tomgrubb/fyp_pcbs/PitchshiftDelay-dsPIC_v2.3.brd

## EAGLE design PitchshiftDelay-dsPIC_v2.3.brd (2018-10-19)

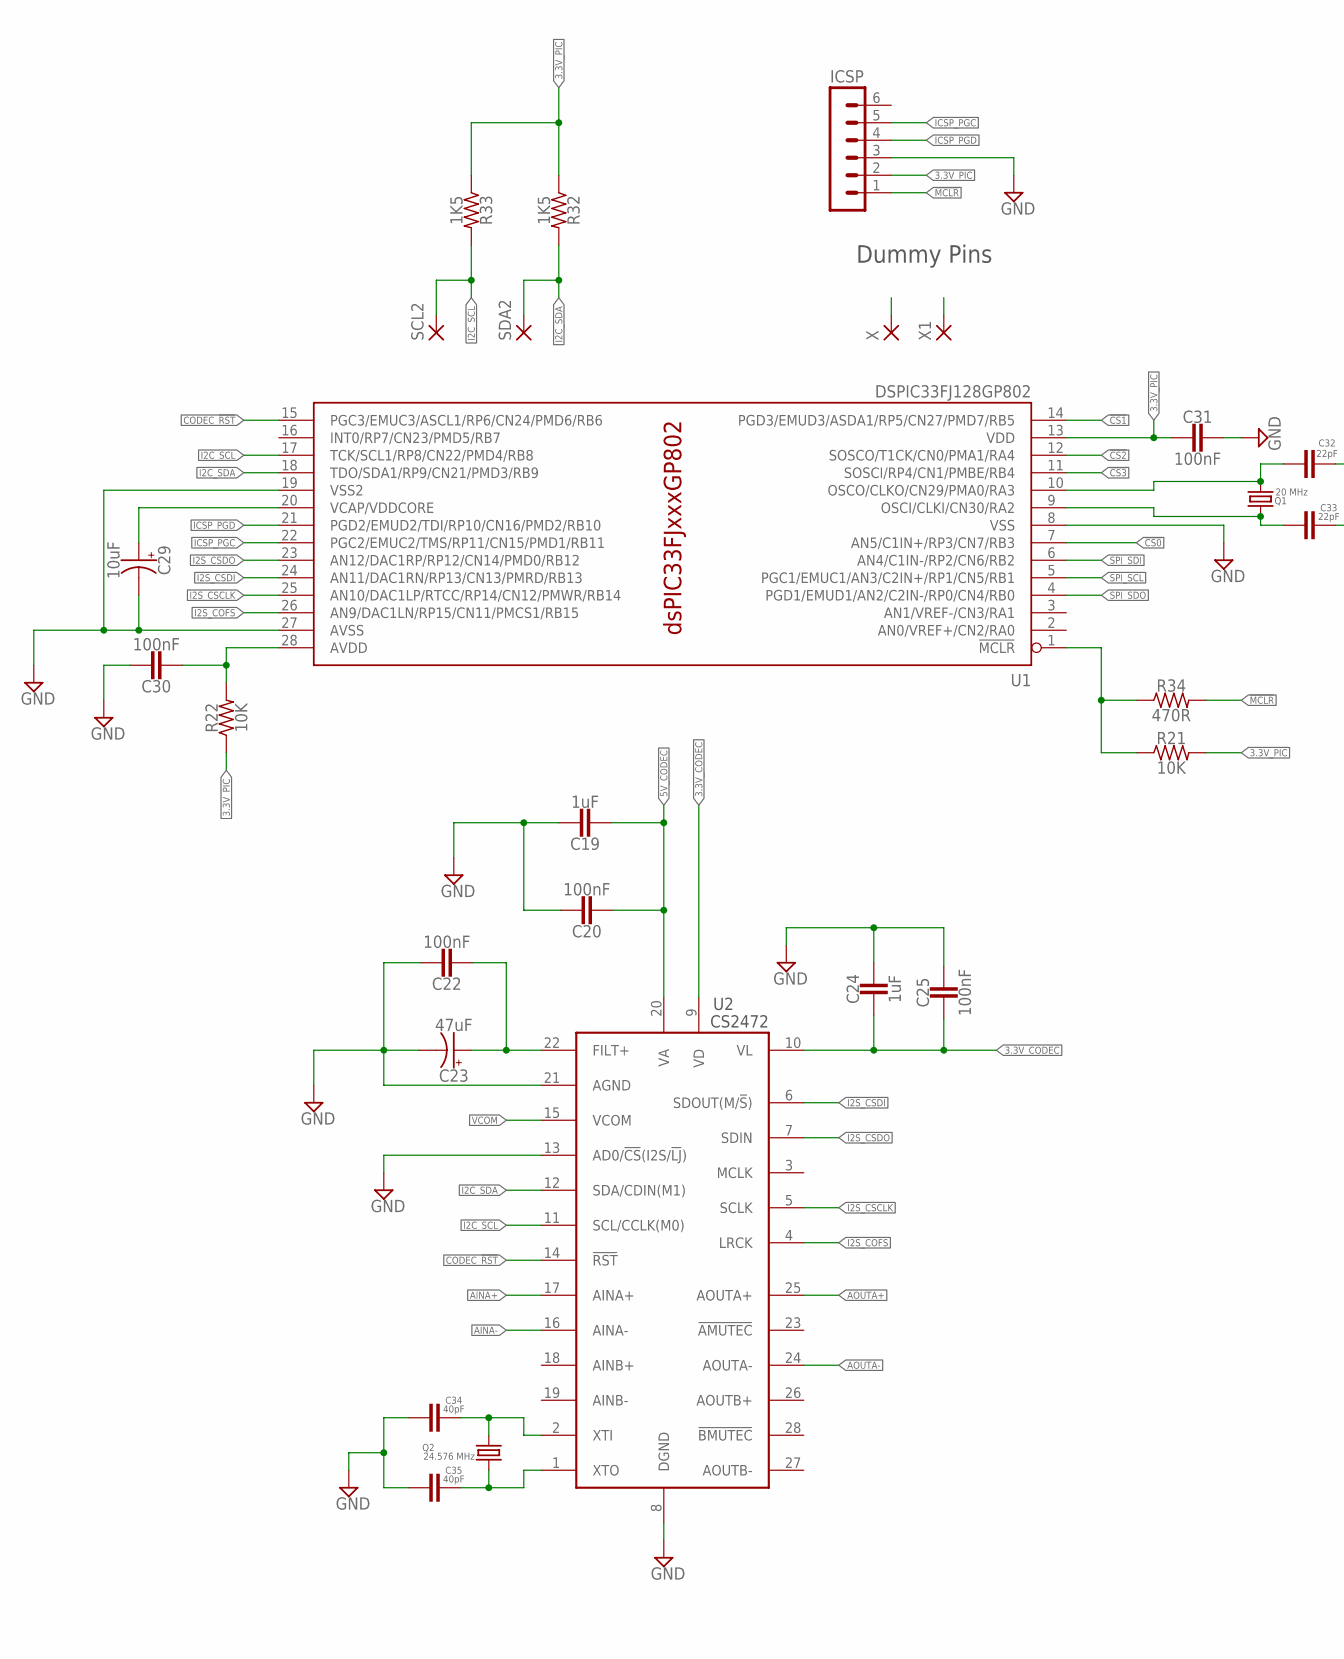
[picture p1: schematic PitchshiftDelay-dsPIC_v2.3.sch, sheet 1, part in row 1, column 1]

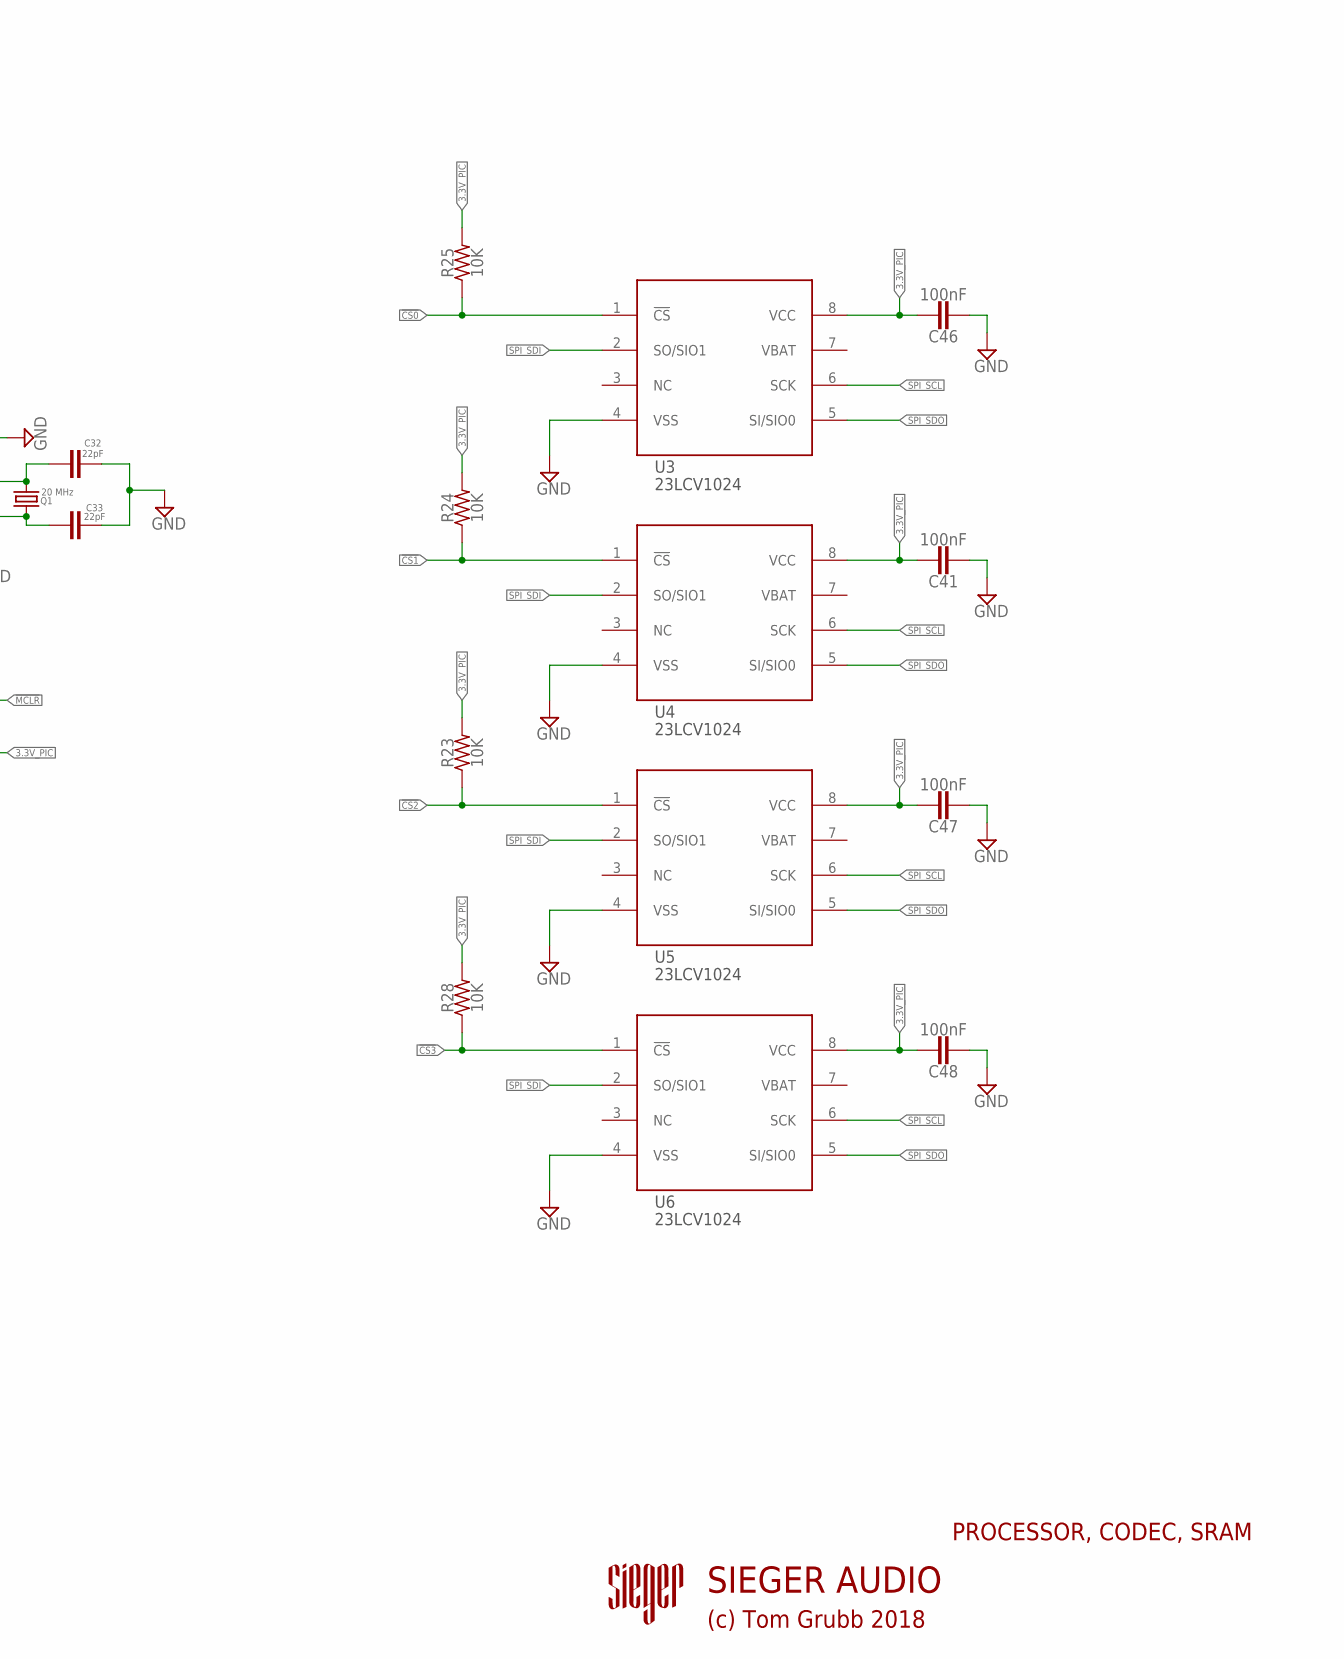
[picture p2: schematic PitchshiftDelay-dsPIC_v2.3.sch, sheet 1, part in row 1, column 2]

Parts:
C19, C24: 1uF; 050X030_025
C20, C22, C25, C30, C31, C41, C46, C47, C48: 100nF; 050X030_025
C23: 47uF; 050_020_1
C29: 10uF; 050_020_1B
C32, C33: 22pF; 0805
C34, C35: 40pF; 0805
ICSP: MA06-1
Q1: 20 MHz; HC49U-V
Q2: 24.576 MHz; HC49U-V
R21, R22, R23, R24, R25, R28: 10K; RESISTOR_C0805
R32, R33: 1K5; RESISTOR_C0805
R34: 470R; RESISTOR_C0805
SCL2: 2,15/1,0
SDA2: 2,15/1,0
U1: DSPIC33FJ128GP802; SO28W
U2: CS2472; TSSOP28L
U3, U4, U5, U6: 23LCV1024; SOIC8
X, X1: 2,15/1,0

Connections:
3.3V_CODEC: C24.2, C25.2, U2.9 (VD), U2.10 (VL); also elsewhere on the board
3.3V_PIC: C31.2, C41.1, C46.1, C47.1, C48.1, ICSP.2, R21.2, R22.1, R23.2, R24.2, R25.2, R28.2, R32.1, R33.1, U1.13 (VDD), U3.8 (VCC), U4.8 (VCC), U5.8 (VCC), U6.8 (VCC); also elsewhere on the board
5V_CODEC: C19.2, C20.2, U2.20 (VA); also elsewhere on the board
!CS0: R25.1, U1.7 (AN5/C1IN+/RP3/CN7/RB3), U3.1 (!CS)
!CS1: R24.1, U1.14 (PGD3/EMUD3/ASDA1/RP5/CN27/PMD7/RB5), U4.1 (!CS)
!CS2: R23.1, U1.12 (SOSCO/T1CK/CN0/PMA1/RA4), U5.1 (!CS)
!CS3: R28.1, U1.11 (SOSCI/RP4/CN1/PMBE/RB4), U6.1 (!CS)
!MCLR: ICSP.1, R34.2
AINA+: U2.17 (AINA+); also elsewhere on the board
AINA-: U2.16 (AINA-); also elsewhere on the board
AOUTA+: U2.25 (AOUTA+); also elsewhere on the board
AOUTA-: U2.24 (AOUTA-); also elsewhere on the board
CODEC_!RST: U1.15 (PGC3/EMUC3/ASCL1/RP6/CN24/PMD6/RB6), U2.14 (!RST)
FILT+: C22.2, C23.+, U2.22 (FILT+)
GND: C19.1, C20.1, C22.1, C23.-, C24.1, C25.1, C29.-, C30.1, C31.1, C32.1, C33.1, C34.2, C35.2, C41.2, C46.2, C47.2, C48.2, ICSP.3, U1.8 (VSS), U1.19 (VSS2), U1.27 (AVSS), U2.8 (DGND), U2.13 (AD0/!CS!(I2S/!LJ!)), U2.21 (AGND), U3.4 (VSS), U4.4 (VSS), U5.4 (VSS), U6.4 (VSS); also elsewhere on the board
I2C_SCL: R33.2, SCL2.1, U1.17 (TCK/SCL1/RP8/CN22/PMD4/RB8), U2.11 (SCL/CCLK(M0)), X.1
I2C_SDA: R32.2, SDA2.1, U1.18 (TDO/SDA1/RP9/CN21/PMD3/RB9), U2.12 (SDA/CDIN(M1))
I2S_COFS: U1.26 (AN9/DAC1LN/RP15/CN11/PMCS1/RB15), U2.4 (LRCK)
I2S_CSCLK: U1.25 (AN10/DAC1LP/RTCC/RP14/CN12/PMWR/RB14), U2.5 (SCLK)
I2S_CSDI: U1.24 (AN11/DAC1RN/RP13/CN13/PMRD/RB13), U2.6 (SDOUT(M/!S!))
I2S_CSDO: U1.23 (AN12/DAC1RP/RP12/CN14/PMD0/RB12), U2.7 (SDIN)
ICSP_PGC: ICSP.5, U1.22 (PGC2/EMUC2/TMS/RP11/CN15/PMD1/RB11)
ICSP_PGD: ICSP.4, U1.21 (PGD2/EMUD2/TDI/RP10/CN16/PMD2/RB10)
unnamed: C30.2, R22.2, U1.28 (AVDD)
unnamed: C29.+, U1.20 (VCAP/VDDCORE)
unnamed: C33.2, Q1.1, U1.9 (OSCI/CLKI/CN30/RA2)
unnamed: C32.2, Q1.2, U1.10 (OSCO/CLKO/CN29/PMA0/RA3)
unnamed: R21.1, R34.1, U1.1 (!MCLR)
unnamed: C34.1, Q2.2, U2.2 (XTI)
unnamed: C35.1, Q2.1, U2.1 (XTO)
SPI_SCL: U1.5 (PGC1/EMUC1/AN3/C2IN+/RP1/CN5/RB1), U3.6 (SCK), U4.6 (SCK), U5.6 (SCK), U6.6 (SCK)
SPI_SDI: U1.6 (AN4/C1IN-/RP2/CN6/RB2), U3.2 (SO/SIO1), U4.2 (SO/SIO1), U5.2 (SO/SIO1), U6.2 (SO/SIO1)
SPI_SDO: U1.4 (PGD1/EMUD1/AN2/C2IN-/RP0/CN4/RB0), U3.5 (SI/SIO0), U4.5 (SI/SIO0), U5.5 (SI/SIO0), U6.5 (SI/SIO0)
VCOM: U2.15 (VCOM); also elsewhere on the board

Notes on the sheet:
PROCESSOR, CODEC, SRAM
Dummy Pins
(c) Tom Grubb 2018
SIEGER AUDIO

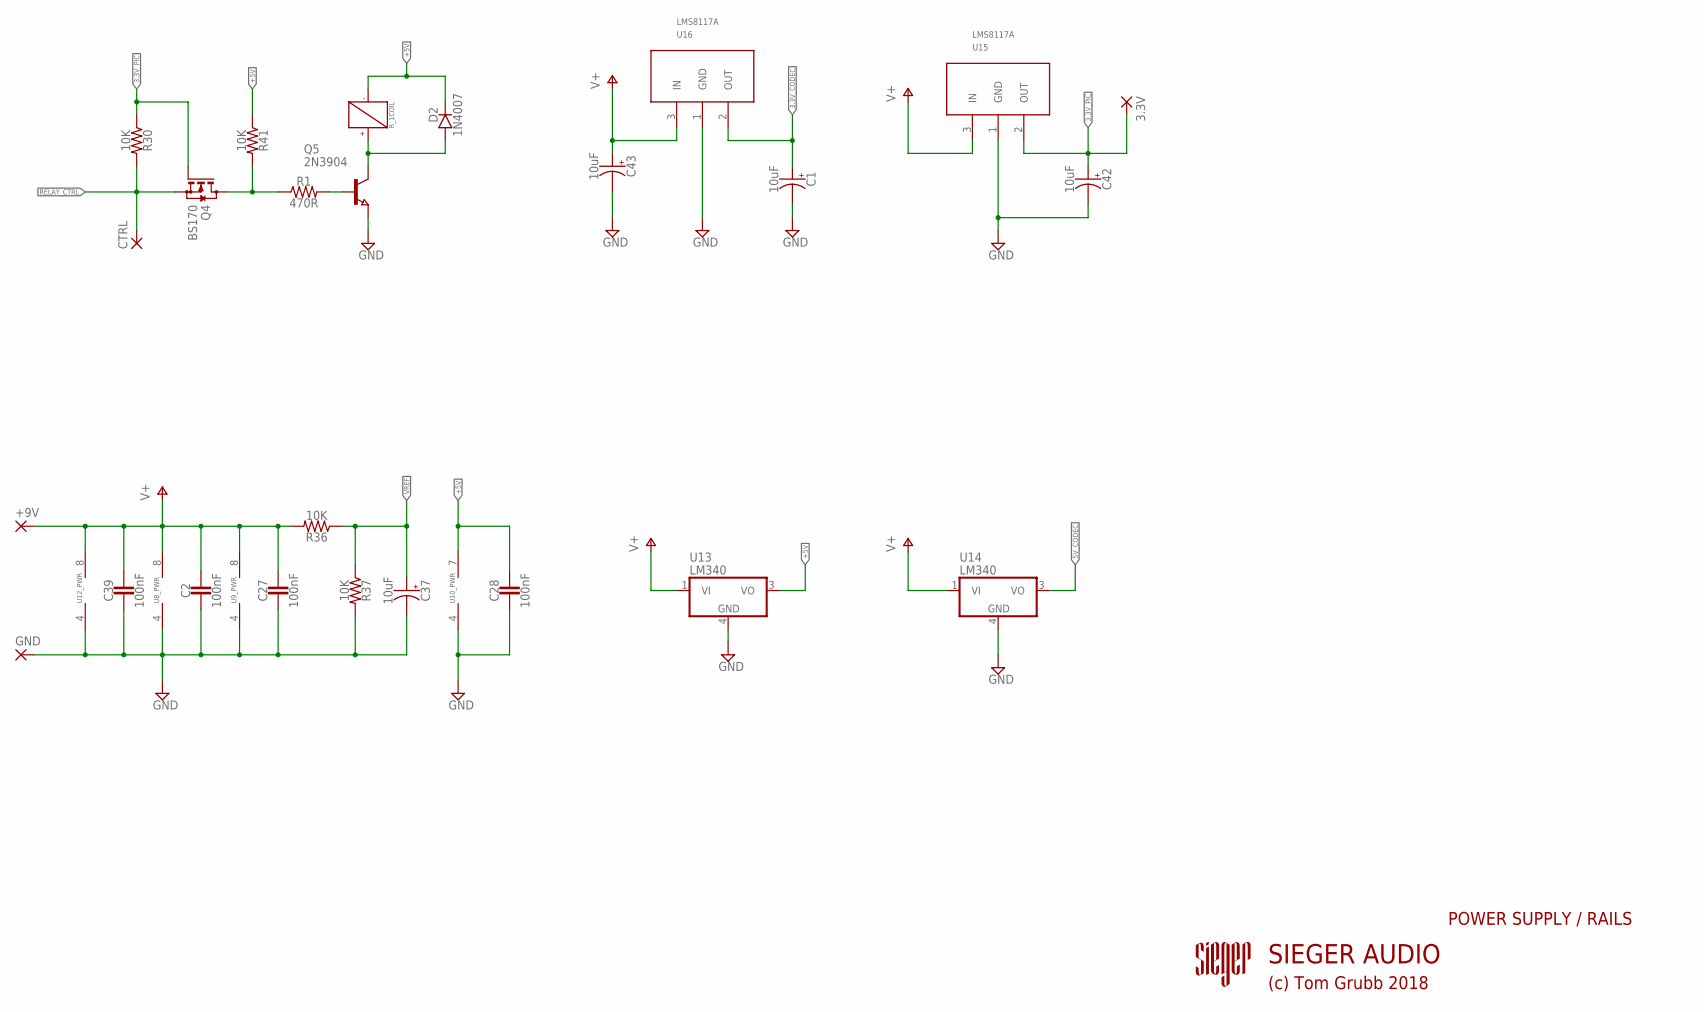
[picture p3: schematic PitchshiftDelay-dsPIC_v2.3.sch, sheet 2]

Parts:
3.3V: 2,15/1,0
+9V: 2,15/1,0
C1, C37, C42, C43: 10uF; 050_020_1
C2, C27, C28, C39: 100nF; 050X030_025
CTRL: 2,15/1,0
D2: 1N4007; DO35-3
GND: 2,15/1,0
Q4: BS170; SOT23
Q5: 2N3904; SOT23
R1: 470R; RESISTOR_C0805
R30, R36, R37, R41: 10K; RESISTOR_C0805
R_1: AL5WNK_2; 10PIN
U8, U9, U12: LF353; SO08
U10: OP1177; MSOP8
U13, U14: LM340; SOT223
U15, U16: LMS8117A; SOT223

Connections:
3.3V_CODEC: C1.+, U16.2 (OUT); also elsewhere on the board
3.3V_PIC: 3.3V.1, C42.+, Q4.1 (G), R30.1, U15.2 (OUT); also elsewhere on the board
5V_CODEC: U14.3 (VO); also elsewhere on the board
+5V: C28.1, D2.C, R41.1, R_1.P$10 (-), U10.7 (V+), U13.3 (VO); also elsewhere on the board
GND: C1.-, C2.2, C27.2, C28.2, C37.-, C39.2, C42.-, C43.-, GND.1, Q5.2 (E), R37.2, U8.4 (V-), U9.4 (V-), U10.4 (V-), U12.4 (V-), U13.4 (GND), U14.4 (GND), U15.1 (GND), U16.1 (GND); also elsewhere on the board
unnamed: Q5.1 (B), R1.2
unnamed: D2.A, Q5.3 (C), R_1.P$1 (+)
unnamed: Q4.3 (D), R1.1, R41.2
RELAY_CTRL: CTRL.1, Q4.2 (S), R30.2
V+: +9V.1, C2.1, C27.1, C39.1, C43.+, R36.2, U8.8 (V+), U9.8 (V+), U12.8 (V+), U13.1 (VI), U14.1 (VI), U15.3 (IN), U16.3 (IN)
VREF: C37.+, R36.1, R37.1; also elsewhere on the board

Notes on the sheet:
POWER SUPPLY / RAILS
(c) Tom Grubb 2018
SIEGER AUDIO

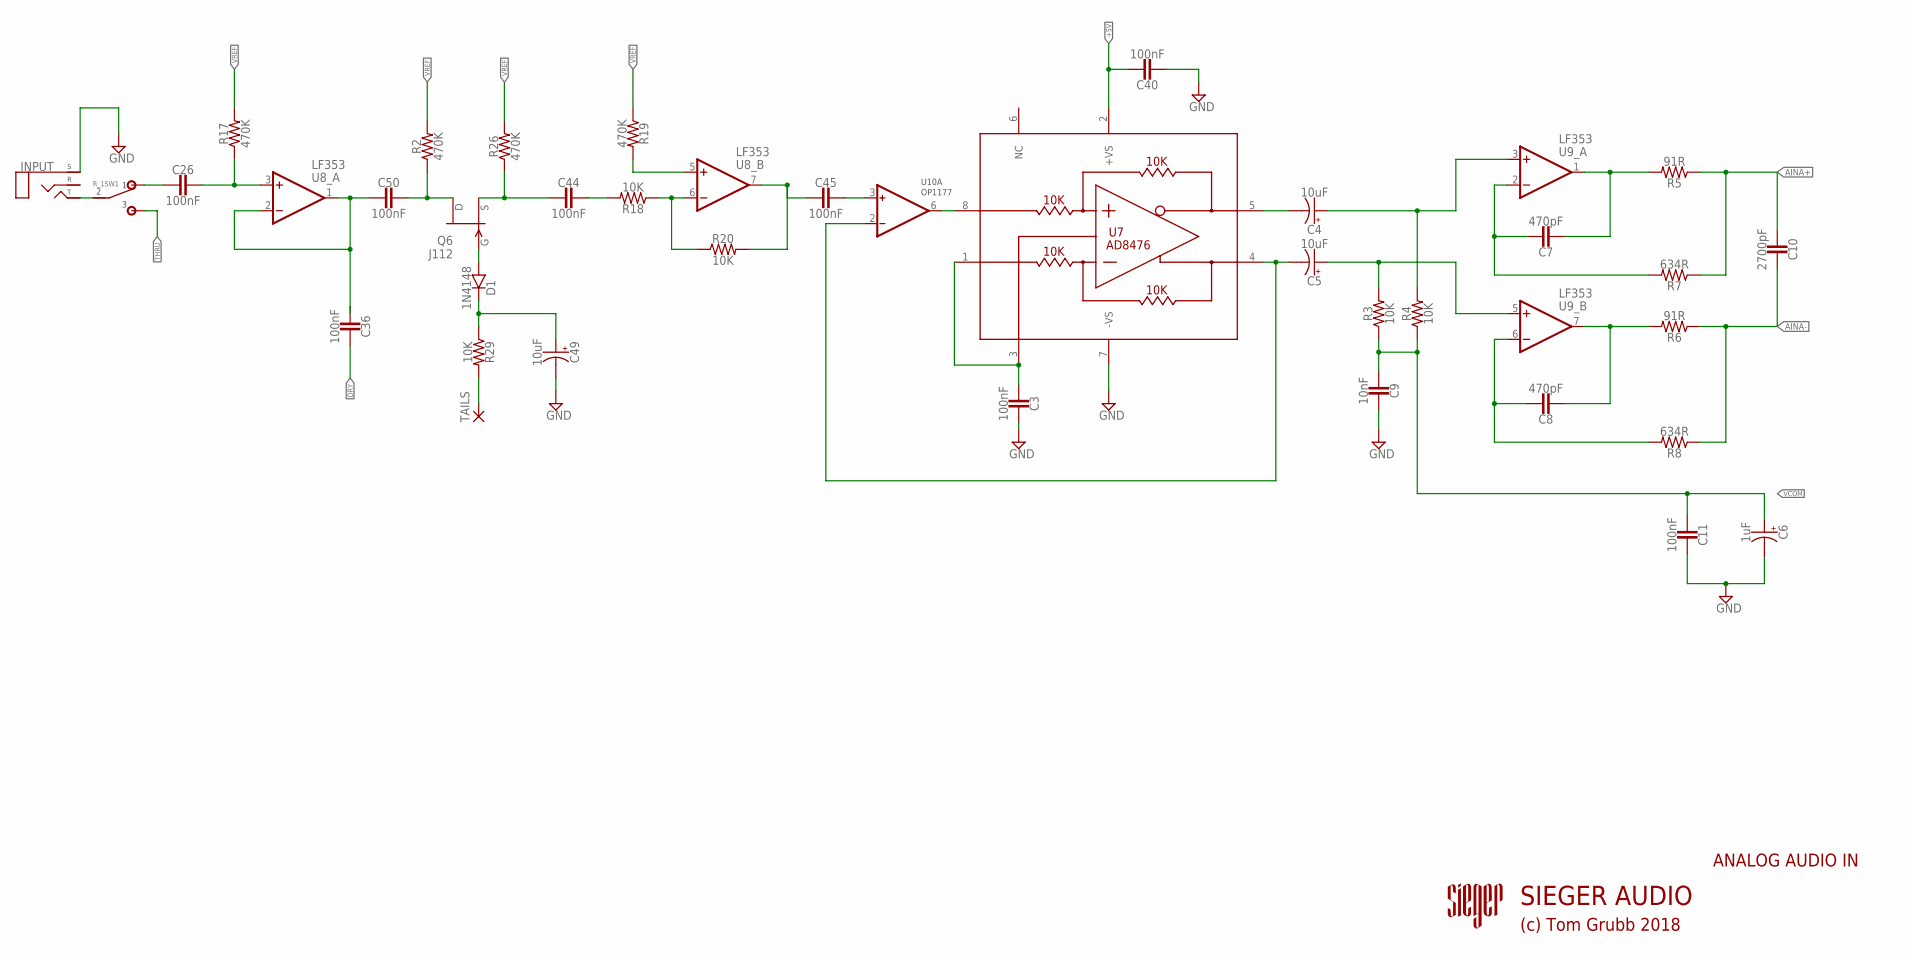
[picture p4: schematic PitchshiftDelay-dsPIC_v2.3.sch, sheet 3]

Parts:
C3, C11, C40: 100nF; 050X030_025
C4, C5, C49: 10uF; 050_020_1
C6: 1uF; 050_020_1
C7, C8: 470pF; BOX_SMALL
C9: 10nF; 050X030_025
C10: 2700pF; BOX_SMALL
C26, C36, C44, C45, C50: 100nF; BOX_SMALL
D1: 1N4148; DO35-3
INPUT: STEREO; STEREO_PCB
Q6: J112; SOT23
R2, R17, R19, R26: 470K; RESISTOR_C0805
R3, R4, R18, R20, R29: 10K; RESISTOR_C0805
R5, R6: 91R; RESISTOR_C0805
R7, R8: 634R; RESISTOR_C0805
R_1: AL5WNK_2; 10PIN
TAILS: 2,15/1,0
U7: AD8476; MSOP8
U8, U9: LF353; SO08
U10: OP1177; MSOP8

Connections:
+5V: C40.1, U7.2 (+VS); also elsewhere on the board
AINA+: C10.2, R5.1, R7.1; also elsewhere on the board
AINA-: C10.1, R6.1, R8.1; also elsewhere on the board
DRY: C36.1; also elsewhere on the board
GND: C3.1, C6.-, C9.1, C11.1, C40.2, C49.-, INPUT.P$1 (S), U7.7 (-VS); also elsewhere on the board
unnamed: C45.1, U10.3 (+IN)
unnamed: C3.2, U7.1 (IN-), U7.3 (VCOM)
unnamed: U7.8 (IN+), U10.6 (OUT)
unnamed: C5.-, U7.4 (+OUT), U10.2 (-IN)
unnamed: C36.2, C50.2, U8.1 (OUT), U8.2 (-IN)
unnamed: C26.1, R17.1, U8.3 (+IN)
unnamed: C4.-, U7.5 (-OUT)
unnamed: C5.+, R3.2, U9.5 (+IN)
unnamed: C4.+, R4.2, U9.3 (+IN)
unnamed: C8.1, R8.2, U9.6 (-IN)
unnamed: C8.2, R6.2, U9.7 (OUT)
unnamed: C7.1, R7.2, U9.2 (-IN)
unnamed: C7.2, R5.2, U9.1 (OUT)
unnamed: C26.2, R_1.P$2 (1)
unnamed: R18.1, R20.1, U8.6 (-IN)
unnamed: R19.2, U8.5 (+IN)
unnamed: C50.1, Q6.1 (D), R2.1
unnamed: C45.2, R20.2, U8.7 (OUT)
unnamed: C44.1, R18.2
unnamed: INPUT.P$3 (T), R_1.P$3 (2)
unnamed: C44.2, Q6.2 (S), R26.1
unnamed: C49.+, D1.C, R29.1
unnamed: D1.A, Q6.3 (G)
unnamed: R29.2, TAILS.1
THRU: R_1.P$4 (3); also elsewhere on the board
VCOM: C6.+, C9.2, C11.2, R3.1, R4.1; also elsewhere on the board
VREF: R2.2, R17.2, R19.1, R26.2; also elsewhere on the board

Notes on the sheet:
ANALOG AUDIO IN
(c) Tom Grubb 2018
SIEGER AUDIO

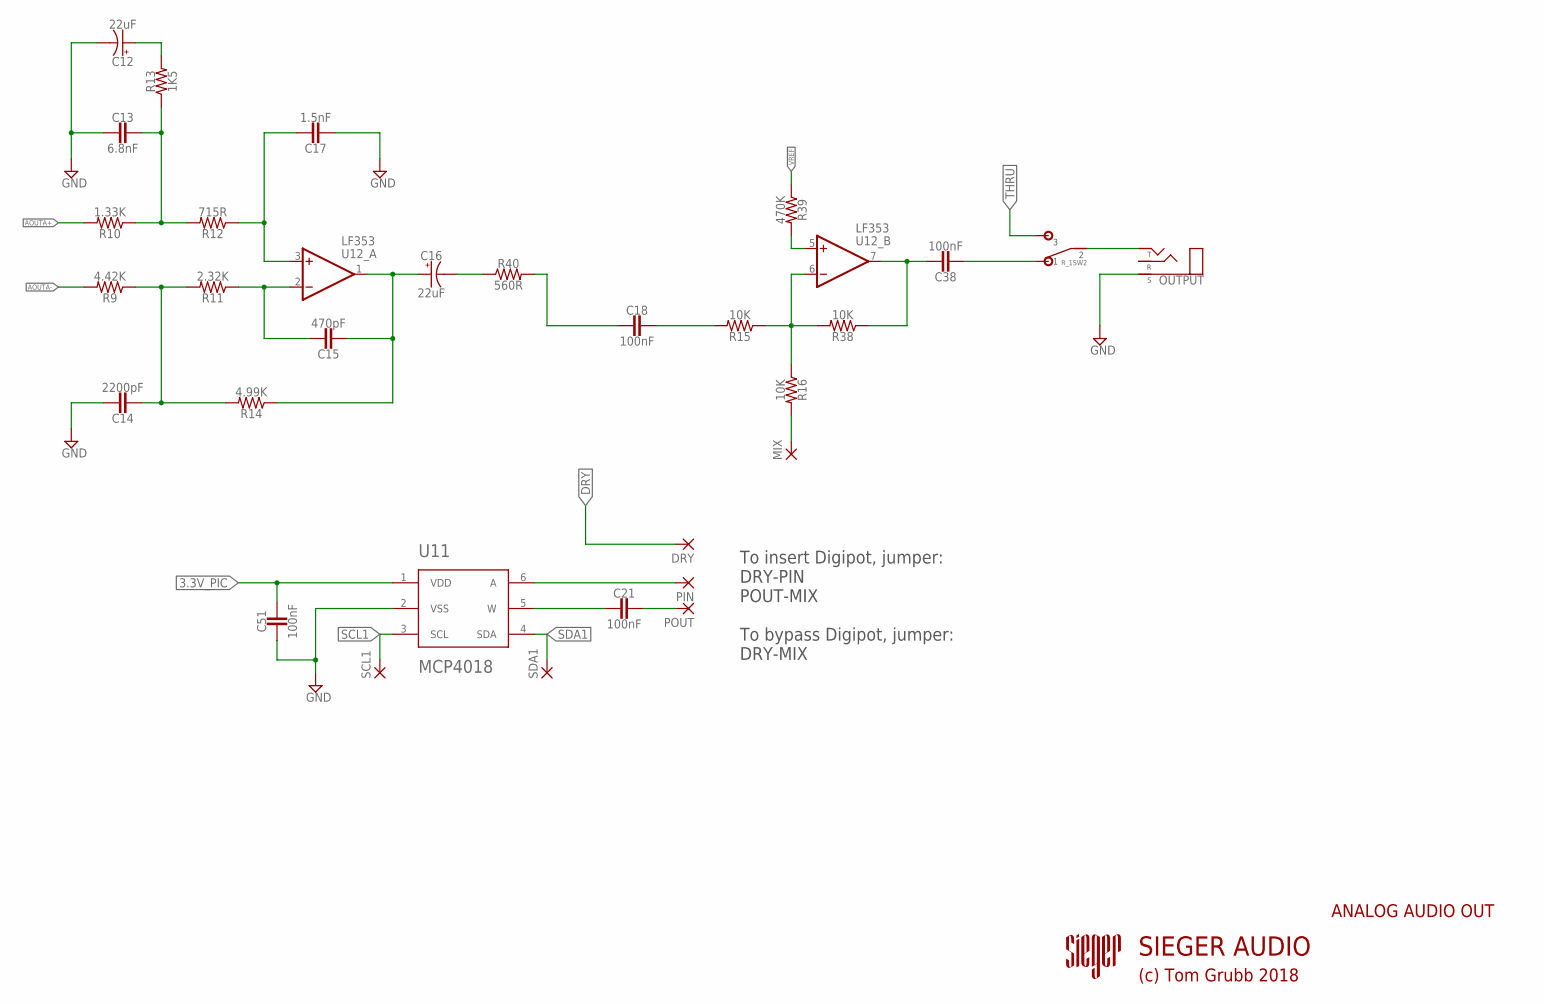
[picture p5: schematic PitchshiftDelay-dsPIC_v2.3.sch, sheet 4]

Parts:
C12, C16: 22uF; 050_020_1
C13: 6.8nF; BOX_SMALL
C14: 2200pF; BOX_SMALL
C15: 470pF; BOX_SMALL
C17: 1.5nF; BOX_SMALL
C18, C21, C38: 100nF; BOX_SMALL
C51: 100nF; 050X030_025
DRY: 2,15/1,0
MIX: 2,15/1,0
OUTPUT: STEREO; STEREO_PCB
PIN: 2,15/1,0
POUT: 2,15/1,0
R9: 4.42K; RESISTOR_C0805
R10: 1.33K; RESISTOR_C0805
R11: 2.32K; RESISTOR_C0805
R12: 715R; RESISTOR_C0805
R13: 1K5; RESISTOR_C0805
R14: 4.99K; RESISTOR_C0805
R15, R16, R38: 10K; RESISTOR_C0805
R39: 470K; RESISTOR_C0805
R40: 560R; RESISTOR_C0805
R_1: AL5WNK_2; 10PIN
SCL1: 2,15/1,0
SDA1: 2,15/1,0
U11: MCP4018; SC70-6
U12: LF353; SO08

Connections:
3.3V_PIC: C51.1, U11.1 (VDD); also elsewhere on the board
AMUTE: C18.2, R40.2
AOUTA+: R10.2; also elsewhere on the board
AOUTA-: R9.2; also elsewhere on the board
DRY: DRY.1; also elsewhere on the board
GND: C12.-, C13.2, C14.1, C17.2, C51.2, OUTPUT.P$1 (S), U11.2 (VSS); also elsewhere on the board
unnamed: C21.2, U11.5 (W)
unnamed: C16.-, R40.1
unnamed: C13.1, R10.1, R12.2, R13.1
unnamed: C14.2, R9.1, R11.2, R14.2
unnamed: C15.1, R11.1, U12.2 (-IN)
unnamed: C17.1, R12.1, U12.3 (+IN)
unnamed: C15.2, C16.+, R14.1, U12.1 (OUT)
unnamed: MIX.1, R16.2
unnamed: C18.1, R15.2
unnamed: C12.+, R13.2
unnamed: OUTPUT.P$3 (T), R_1.P$8 (2)
unnamed: C38.2, R_1.P$9 (1)
unnamed: PIN.1, U11.6 (A)
unnamed: R15.1, R16.1, R38.2, U12.6 (-IN)
unnamed: C38.1, R38.1, U12.7 (OUT)
unnamed: R39.2, U12.5 (+IN)
unnamed: C21.1, POUT.1
SCL1: SCL1.1, U11.3 (SCL)
SDA1: SDA1.1, U11.4 (SDA)
THRU: R_1.P$7 (3); also elsewhere on the board
VREF: R39.1; also elsewhere on the board

Notes on the sheet:
To insert Digipot, jumper: DRY-PIN POUT-MIX To bypass Digipot, jumper: DRY-MIX
ANALOG AUDIO OUT
(c) Tom Grubb 2018
SIEGER AUDIO

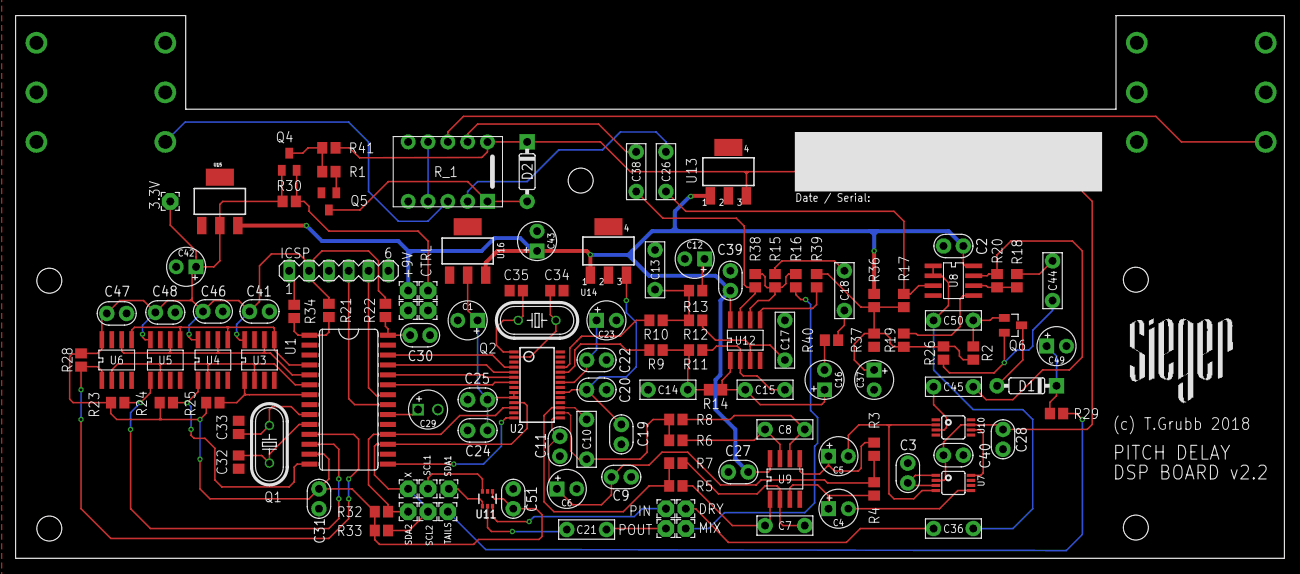
[picture p6: board PitchshiftDelay-dsPIC_v2.3.brd from above]

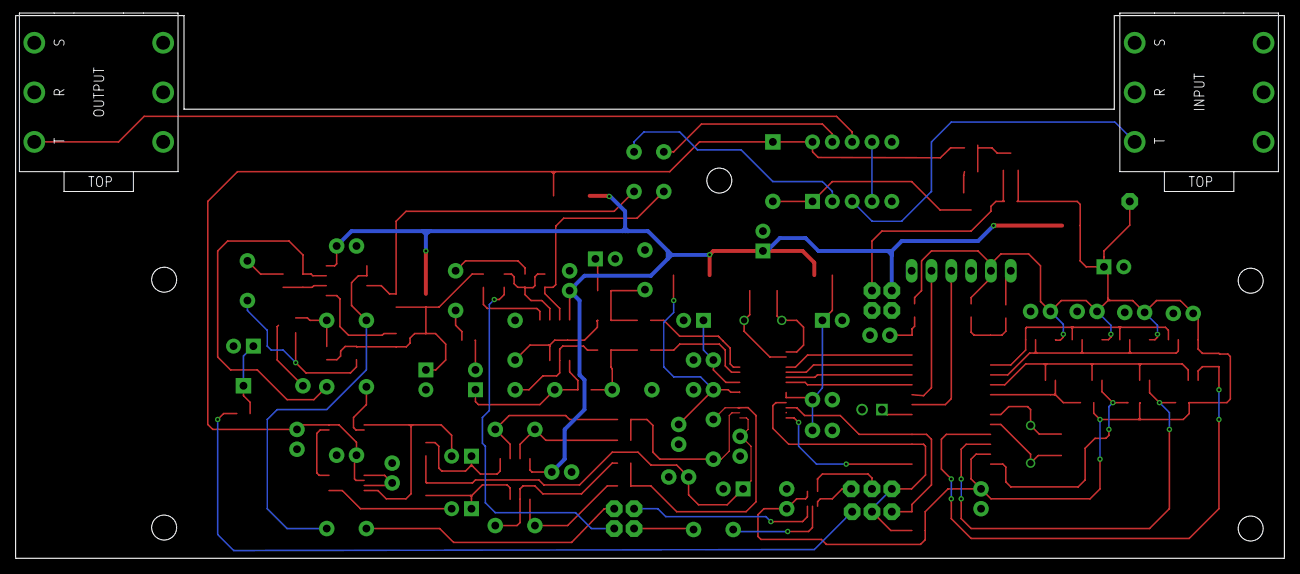
[picture p7: board PitchshiftDelay-dsPIC_v2.3.brd from below]

Board: 2 copper layers, 162.5 x 69.5 mm, 132 parts (2 on the bottom side), 87 nets.

Other parts of the board:
U$1: LARGE
