tomgrubb/fyp_pcbs/PitchshiftDelay-Control-v1.2.brd

## EAGLE design PitchshiftDelay-Control-v1.2.brd (2018-10-19)

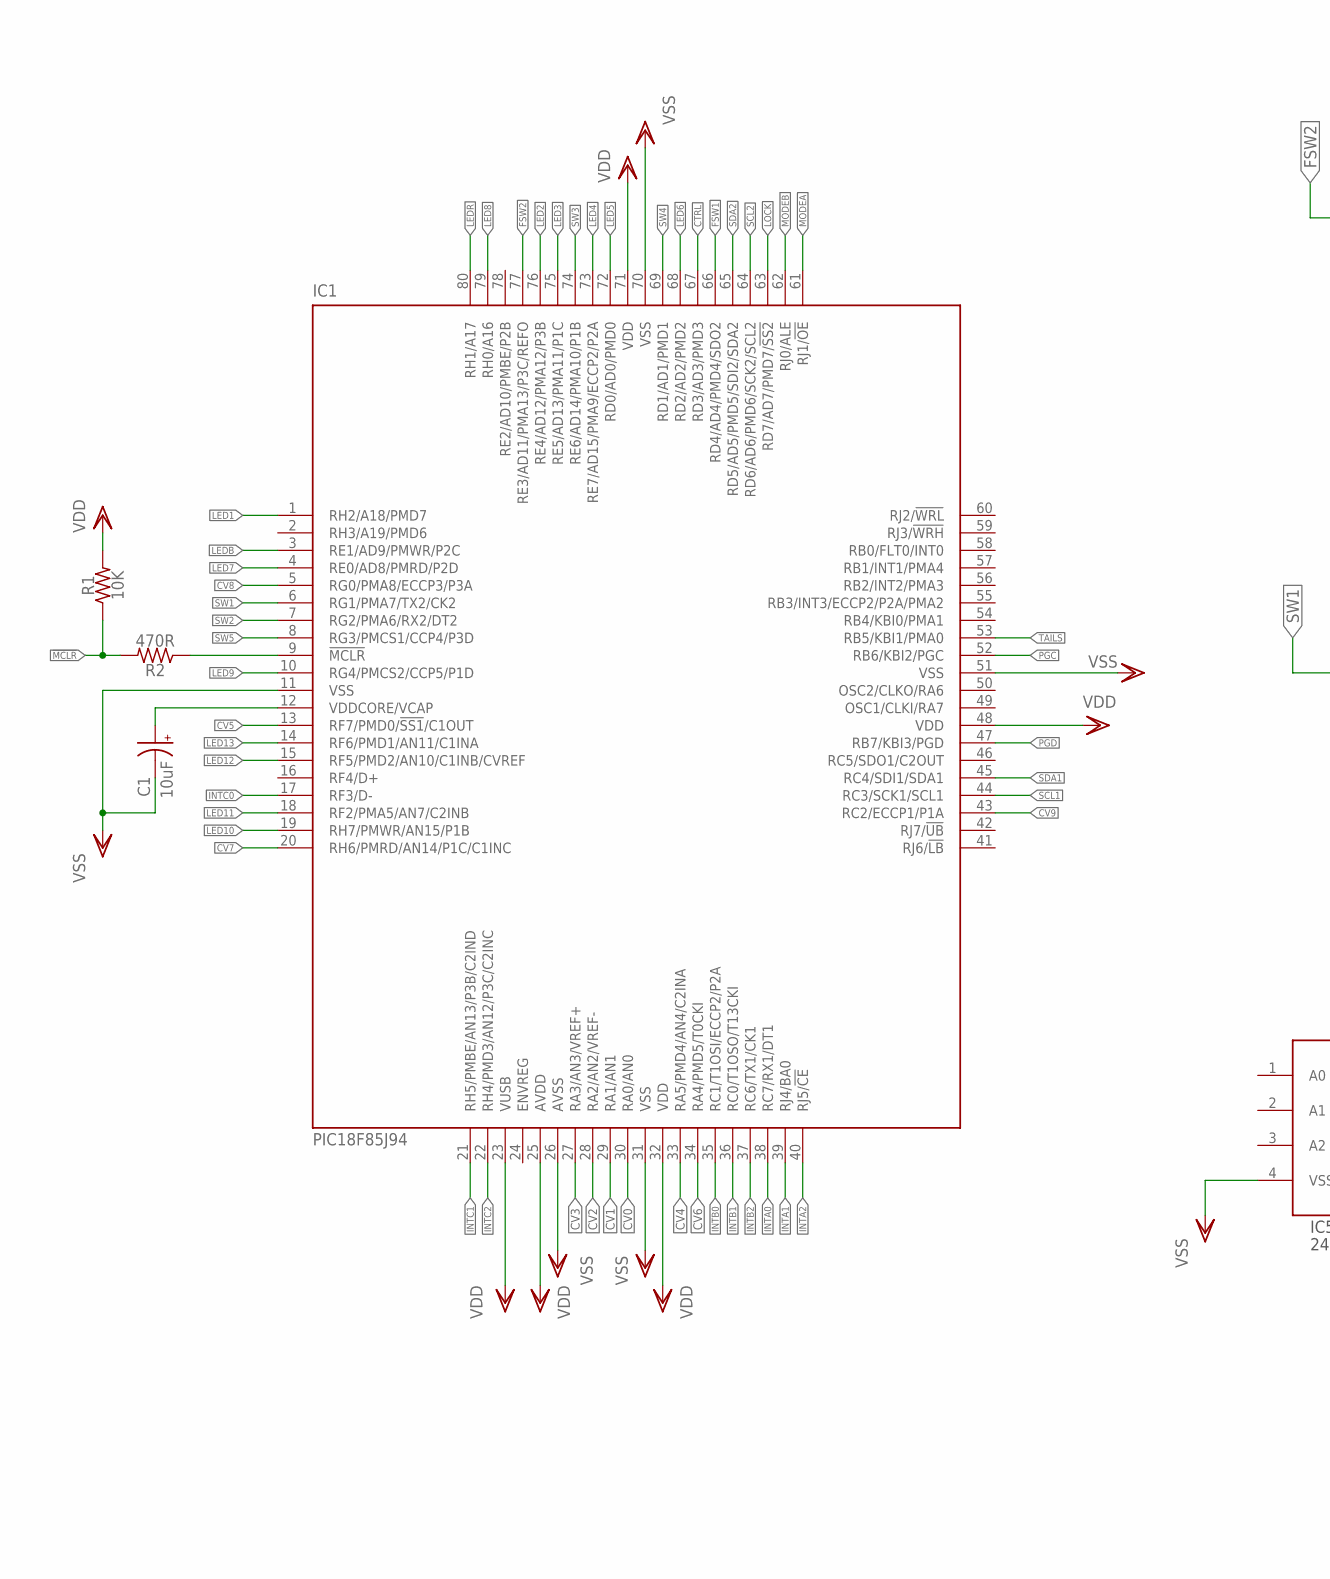
[picture p8: schematic PitchshiftDelay-Control-v1.2.sch, sheet 1, part in row 1, column 1]

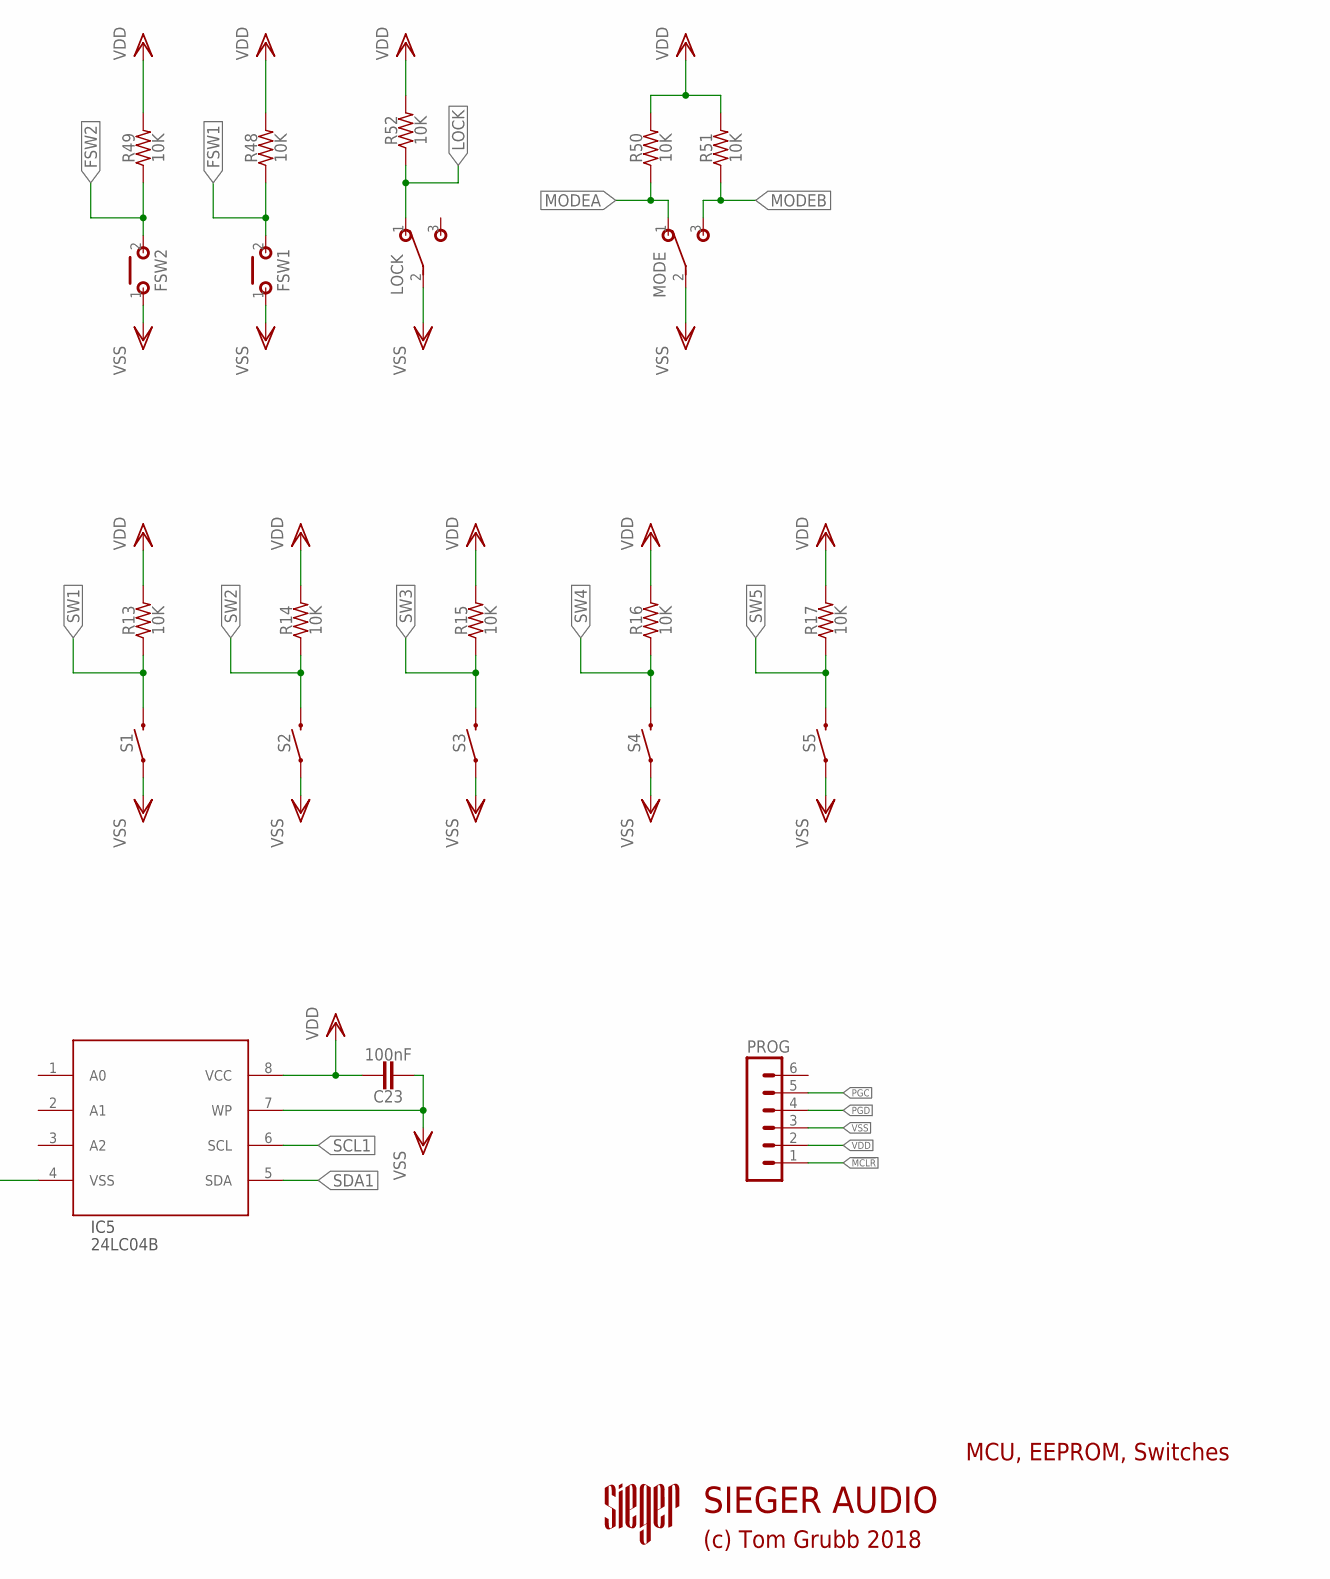
[picture p9: schematic PitchshiftDelay-Control-v1.2.sch, sheet 1, part in row 1, column 2]

Parts:
C1: 10uF; 050_020_1
C23: 100nF; 050X030_025
FSW1, FSW2: MOMENTARY; SPST
IC1: PIC18F85J94; TQFP80-12X12
IC5: 24LC04B; SOIC8
LOCK: SPDTPIN_MOUNT; 1MS1T1B1C0M2QE
MODE: SPDTPIN_MOUNT; 1MS1T1B1C0M2QE
PROG: MA06-1
R1, R13, R14, R15, R16, R17, R48, R49, R50, R51, R52: 10K; RESISTOR_C0805
R2: 470R; RESISTOR_C0805
S1, S2, S3, S4, S5: MOMENTARY-SWITCH-SPST-PTH-6.0MM; TACTILE_SWITCH_PTH_6.0MM

Connections:
!MCLR: PROG.1, R1.1, R2.2
CTRL: IC1.67 (RD3/AD3/PMD3); also elsewhere on the board
CV0: IC1.30 (RA0/AN0); also elsewhere on the board
CV1: IC1.29 (RA1/AN1); also elsewhere on the board
CV2: IC1.28 (RA2/AN2/VREF-); also elsewhere on the board
CV3: IC1.27 (RA3/AN3/VREF+); also elsewhere on the board
CV4: IC1.33 (RA5/PMD4/AN4/C2INA); also elsewhere on the board
CV5: IC1.13 (RF7/PMD0/!SS1!/C1OUT); also elsewhere on the board
CV6: IC1.34 (RA4/PMD5/T0CKI); also elsewhere on the board
CV7: IC1.20 (RH6/PMRD/AN14/P1C/C1INC); also elsewhere on the board
CV8: IC1.5 (RG0/PMA8/ECCP3/P3A); also elsewhere on the board
CV9: IC1.43 (RC2/ECCP1/P1A); also elsewhere on the board
FSW1: FSW1.2 (S), IC1.66 (RD4/AD4/PMD4/SDO2), R48.1
FSW2: FSW2.2 (S), IC1.77 (RE3/AD11/PMA13/P3C/REFO), R49.1
INTA0: IC1.38 (RC7/RX1/DT1); also elsewhere on the board
INTA1: IC1.39 (RJ4/BA0); also elsewhere on the board
INTA2: IC1.40 (RJ5/!CE); also elsewhere on the board
INTB0: IC1.35 (RC1/T1OSI/ECCP2/P2A); also elsewhere on the board
INTB1: IC1.36 (RC0/T1OSO/T13CKI); also elsewhere on the board
INTB2: IC1.37 (RC6/TX1/CK1); also elsewhere on the board
INTC0: IC1.17 (RF3/D-); also elsewhere on the board
INTC1: IC1.21 (RH5/PMBE/AN13/P3B/C2IND); also elsewhere on the board
INTC2: IC1.22 (RH4/PMD3/AN12/P3C/C2INC); also elsewhere on the board
LED1: IC1.1 (RH2/A18/PMD7); also elsewhere on the board
LED2: IC1.76 (RE4/AD12/PMA12/P3B); also elsewhere on the board
LED3: IC1.75 (RE5/AD13/PMA11/P1C); also elsewhere on the board
LED4: IC1.73 (RE7/AD15/PMA9/ECCP2/P2A); also elsewhere on the board
LED5: IC1.72 (RD0/AD0/PMD0); also elsewhere on the board
LED6: IC1.68 (RD2/AD2/PMD2); also elsewhere on the board
LED7: IC1.4 (RE0/AD8/PMRD/P2D); also elsewhere on the board
LED8: IC1.79 (RH0/A16); also elsewhere on the board
LED9: IC1.10 (RG4/PMCS2/CCP5/P1D); also elsewhere on the board
LED10: IC1.19 (RH7/PMWR/AN15/P1B); also elsewhere on the board
LED11: IC1.18 (RF2/PMA5/AN7/C2INB); also elsewhere on the board
LED12: IC1.15 (RF5/PMD2/AN10/C1INB/CVREF); also elsewhere on the board
LED13: IC1.14 (RF6/PMD1/AN11/C1INA); also elsewhere on the board
LEDB: IC1.3 (RE1/AD9/PMWR/P2C); also elsewhere on the board
LEDR: IC1.80 (RH1/A17); also elsewhere on the board
LOCK: IC1.63 (RD7/AD7/PMD7/!SS2), LOCK.1 (O), R52.1
MODEA: IC1.61 (RJ1/!OE), MODE.1 (O), R50.1
MODEB: IC1.62 (RJ0/ALE), MODE.3 (S), R51.1
unnamed: C1.+, IC1.12 (VDDCORE/VCAP)
unnamed: IC1.9 (!MCLR), R2.1
PGC: IC1.52 (RB6/KBI2/PGC), PROG.5
PGD: IC1.47 (RB7/KBI3/PGD), PROG.4
SCL1: IC1.44 (RC3/SCK1/SCL1), IC5.6 (SCL); also elsewhere on the board
SCL2: IC1.64 (RD6/AD6/PMD6/SCK2/SCL2); also elsewhere on the board
SDA1: IC1.45 (RC4/SDI1/SDA1), IC5.5 (SDA); also elsewhere on the board
SDA2: IC1.65 (RD5/AD5/PMD5/SDI2/SDA2); also elsewhere on the board
SW1: IC1.6 (RG1/PMA7/TX2/CK2), R13.1, S1.3 (2)
SW2: IC1.7 (RG2/PMA6/RX2/DT2), R14.1, S2.3 (2)
SW3: IC1.74 (RE6/AD14/PMA10/P1B), R15.1, S3.3 (2)
SW4: IC1.69 (RD1/AD1/PMD1), R16.1, S4.3 (2)
SW5: IC1.8 (RG3/PMCS1/CCP4/P3D), R17.1, S5.3 (2)
TAILS: IC1.53 (RB5/KBI1/PMA0); also elsewhere on the board
VDD: C23.1, IC1.23 (VUSB), IC1.25 (AVDD), IC1.32 (VDD), IC1.48 (VDD), IC1.71 (VDD), IC5.8 (VCC), PROG.2, R1.2, R13.2, R14.2, R15.2, R16.2, R17.2, R48.2, R49.2, R50.2, R51.2, R52.2; also elsewhere on the board
VSS: C1.-, C23.2, FSW1.1, FSW2.1, IC1.11 (VSS), IC1.26 (AVSS), IC1.31 (VSS), IC1.51 (VSS), IC1.70 (VSS), IC5.4 (VSS), IC5.7 (WP), LOCK.2, MODE.2, PROG.3, S1.1, S2.1, S3.1, S4.1, S5.1; also elsewhere on the board

Notes on the sheet:
MCU, EEPROM, Switches
(c) Tom Grubb 2018
SIEGER AUDIO
