tomgrubb/fyp_pcbs/PitchshiftDelay-Control-v1.2.brd

## EAGLE design PitchshiftDelay-Control-v1.2.brd (continued)

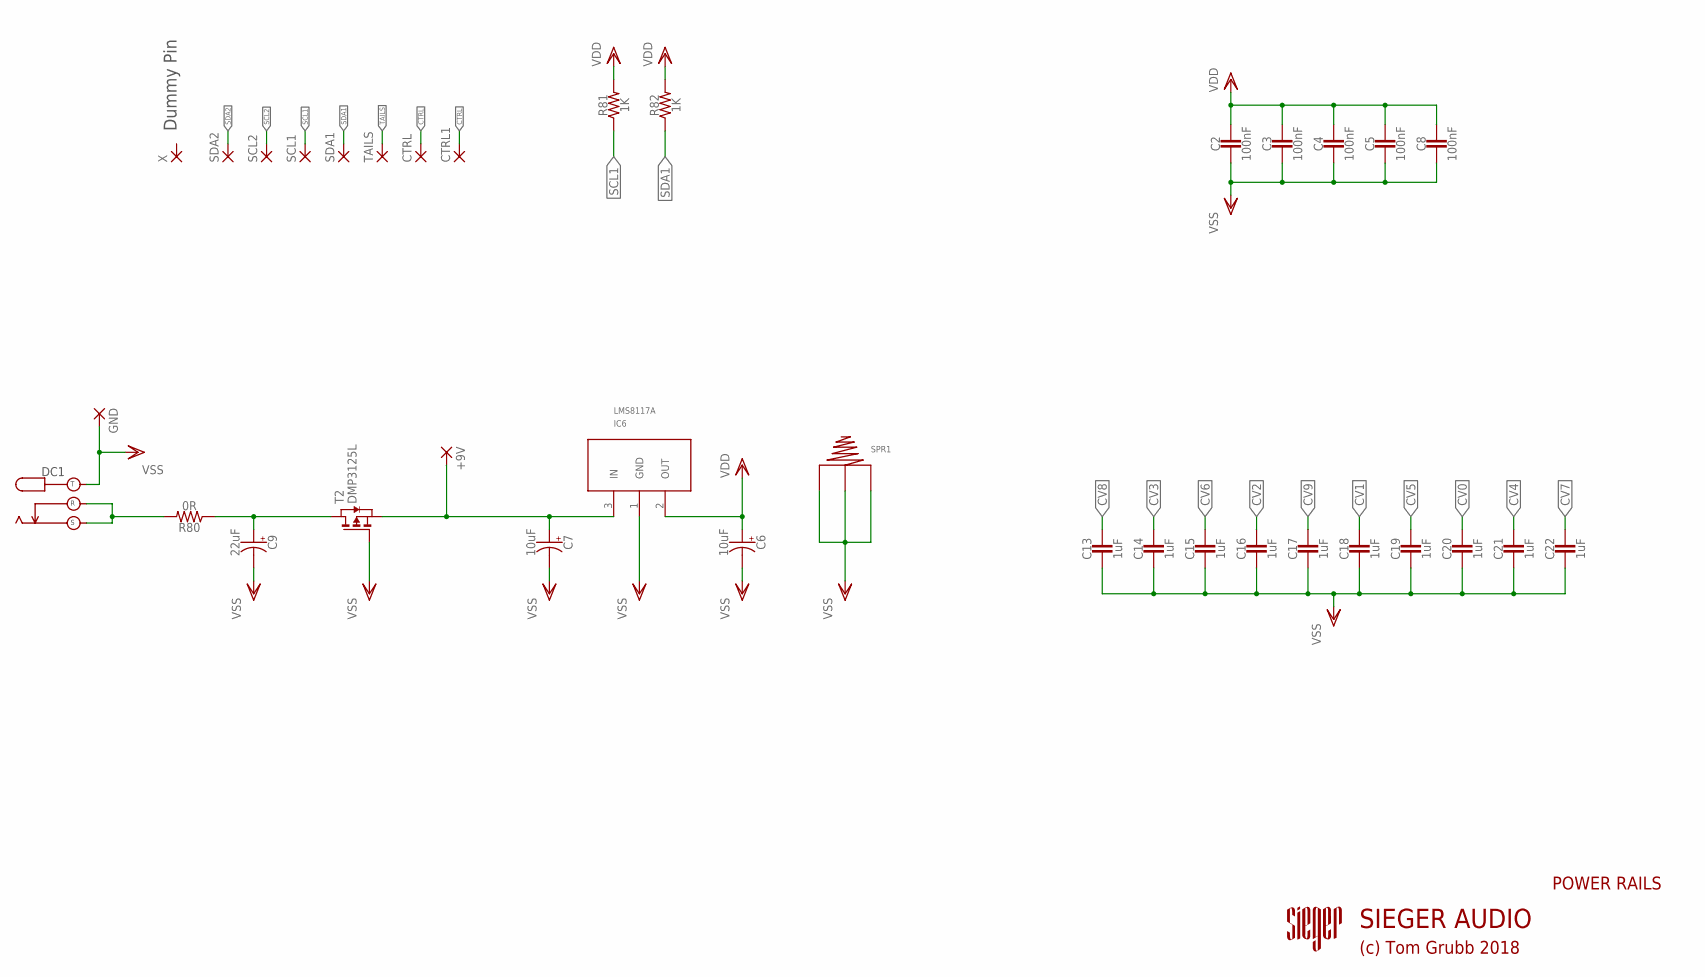
[picture p10: schematic PitchshiftDelay-Control-v1.2.sch, sheet 2]

Parts:
+9V: 2,15/1,0
C2, C3, C4, C5, C8: 100nF; 050X030_025
C6, C7: 10uF; 050_020_1
C9: 22uF; 050_020_1
C13, C14, C15, C16, C17, C18, C19, C20, C21, C22: 1uF; 050X030_025
CTRL, CTRL1: 2,15/1,0
DC1: DC_KOBICONN
GND: 2,15/1,0
IC6: LMS8117A; SOT223
R80: 0R; RESISTOR_C0805
R81, R82: 1K; RESISTOR_C0805
SCL1, SCL2: 2,15/1,0
SDA1, SDA2: 2,15/1,0
SPR1: 534-628; 'A'SIZE-PC-SPRING
T2: DMP3125L; SOT-23
TAILS: 2,15/1,0
X: 2,15/1,0

Connections:
9V: +9V.1, C7.+, IC6.3 (IN), T2.2 (S)
CTRL: CTRL.1, CTRL1.1; also elsewhere on the board
CV0: C20.1; also elsewhere on the board
CV1: C18.1; also elsewhere on the board
CV2: C16.1; also elsewhere on the board
CV3: C14.1; also elsewhere on the board
CV4: C21.1; also elsewhere on the board
CV5: C19.1; also elsewhere on the board
CV6: C15.1; also elsewhere on the board
CV7: C22.1; also elsewhere on the board
CV8: C13.1; also elsewhere on the board
CV9: C17.1; also elsewhere on the board
SCL1: R81.1, SCL1.1; also elsewhere on the board
SCL2: SCL2.1; also elsewhere on the board
SDA1: R82.1, SDA1.1; also elsewhere on the board
SDA2: SDA2.1; also elsewhere on the board
TAILS: TAILS.1; also elsewhere on the board
VDD: C2.1, C3.1, C4.1, C5.1, C6.+, C8.1, IC6.2 (OUT), R81.2, R82.2; also elsewhere on the board
VIN: DC1.R, DC1.S, R80.2
VINF: C9.+, R80.1, T2.1 (D)
VSS: C2.2, C3.2, C4.2, C5.2, C6.-, C7.-, C8.2, C9.-, C13.2, C14.2, C15.2, C16.2, C17.2, C18.2, C19.2, C20.2, C21.2, C22.2, DC1.T, GND.1, IC6.1 (GND), SPR1.P$1, SPR1.P$2, SPR1.P$3, T2.3 (G); also elsewhere on the board

Notes on the sheet:
POWER RAILS
Dummy Pin
(c) Tom Grubb 2018
SIEGER AUDIO

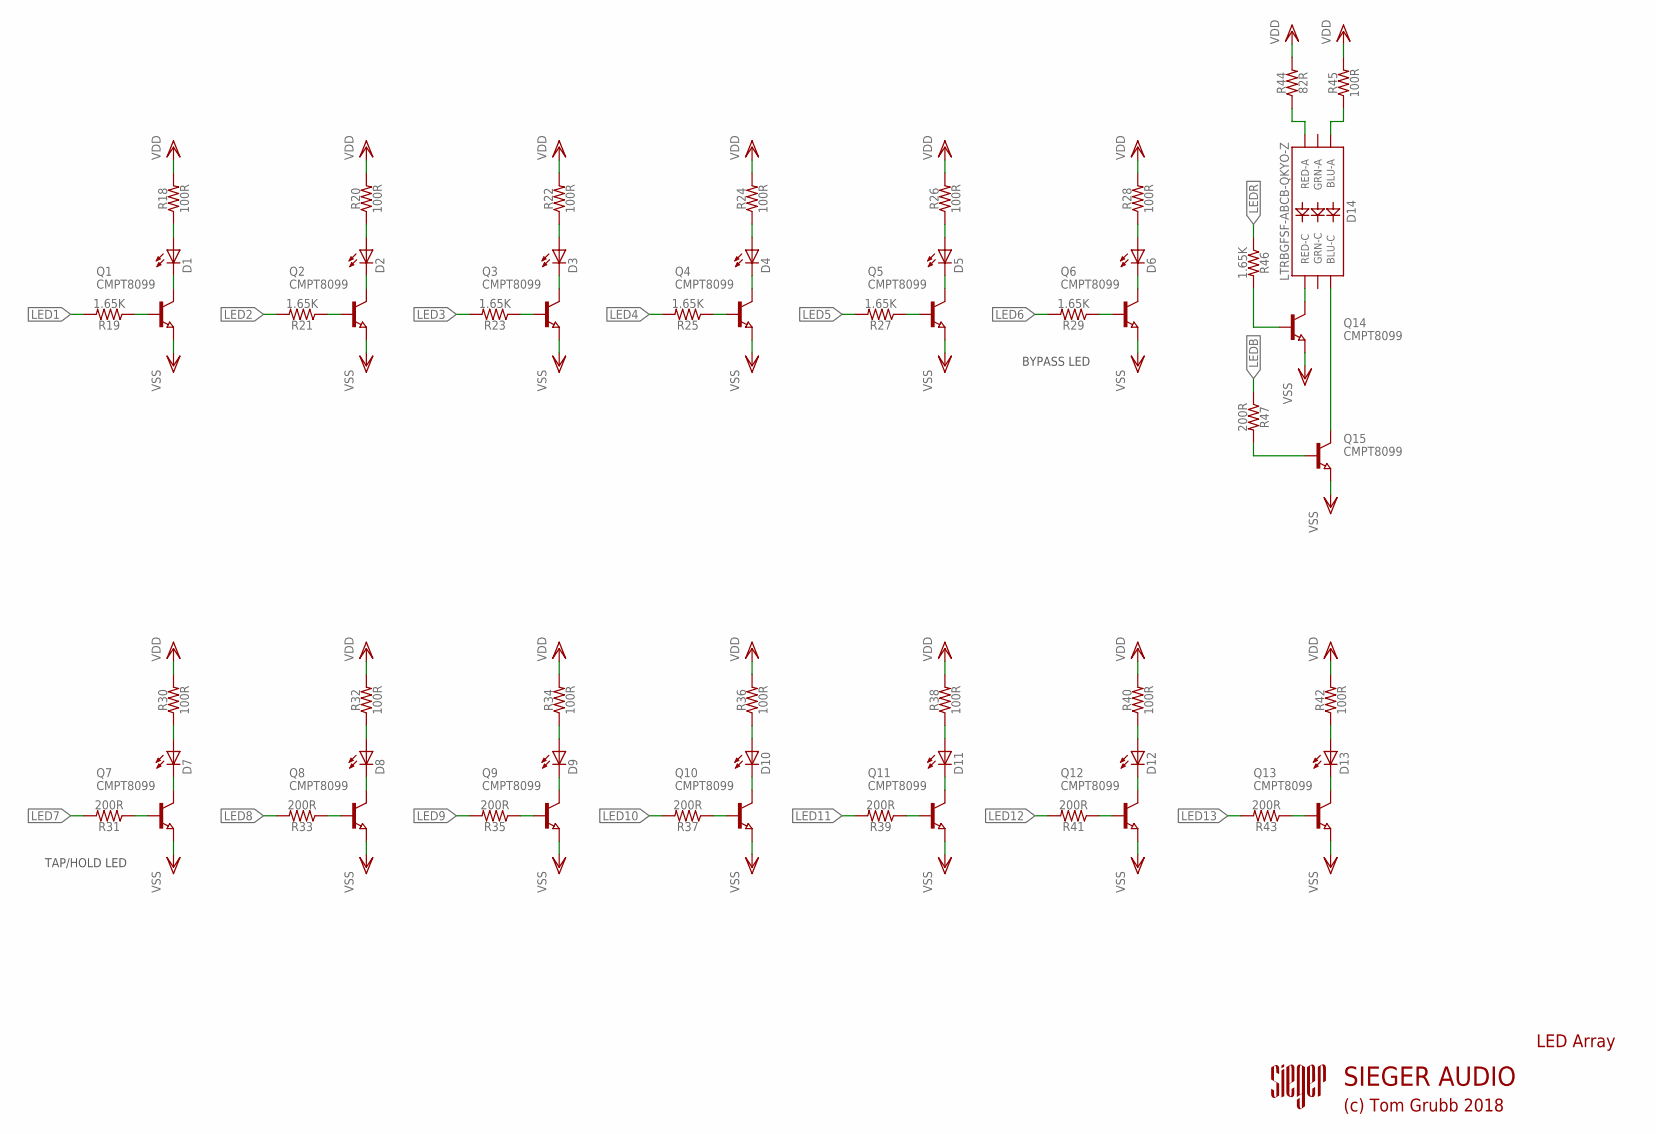
[picture p11: schematic PitchshiftDelay-Control-v1.2.sch, sheet 3]

Parts:
D1, D2, D3, D4, D5, D8, D9, D10, D11, D12, D13: LEDCHIP-LED0805; CHIP-LED0805
D6, D7: LEDCHIPLED_1206; CHIPLED_1206
D14: LTRBGFSF-ABCB-QKYO-Z; PLCC-6-LED
Q1, Q2, Q3, Q4, Q5, Q6, Q7, Q8, Q9, Q10, Q11, Q12, Q13, Q14, Q15: CMPT8099; SOT23
R18, R20, R22, R24, R26, R28, R30, R32, R34, R36, R38, R40, R42, R45: 100R; RESISTOR_C0805
R19, R21, R23, R25, R27, R29, R46: 1.65K; RESISTOR_C0805
R31, R33, R35, R37, R39, R41, R43, R47: 200R; RESISTOR_C0805
R44: 82R; RESISTOR_C0805

Connections:
LED1: R19.2; also elsewhere on the board
LED2: R21.2; also elsewhere on the board
LED3: R23.2; also elsewhere on the board
LED4: R25.2; also elsewhere on the board
LED5: R27.2; also elsewhere on the board
LED6: R29.2; also elsewhere on the board
LED7: R31.2; also elsewhere on the board
LED8: R33.2; also elsewhere on the board
LED9: R35.2; also elsewhere on the board
LED10: R37.2; also elsewhere on the board
LED11: R39.2; also elsewhere on the board
LED12: R41.2; also elsewhere on the board
LED13: R43.2; also elsewhere on the board
LEDB: R47.1; also elsewhere on the board
LEDR: R46.1; also elsewhere on the board
unnamed: D1.C, Q1.3 (C)
unnamed: D1.A, R18.1
unnamed: Q2.1 (B), R21.1
unnamed: D2.C, Q2.3 (C)
unnamed: D2.A, R20.1
unnamed: Q1.1 (B), R19.1
unnamed: Q3.1 (B), R23.1
unnamed: D3.C, Q3.3 (C)
unnamed: D3.A, R22.1
unnamed: Q4.1 (B), R25.1
unnamed: D4.C, Q4.3 (C)
unnamed: D4.A, R24.1
unnamed: Q5.1 (B), R27.1
unnamed: D5.C, Q5.3 (C)
unnamed: D5.A, R26.1
unnamed: Q6.1 (B), R29.1
unnamed: D6.C, Q6.3 (C)
unnamed: D6.A, R28.1
unnamed: Q7.1 (B), R31.1
unnamed: D7.C, Q7.3 (C)
unnamed: D7.A, R30.1
unnamed: Q8.1 (B), R33.1
unnamed: D8.C, Q8.3 (C)
unnamed: D8.A, R32.1
unnamed: Q9.1 (B), R35.1
unnamed: D9.C, Q9.3 (C)
unnamed: D9.A, R34.1
unnamed: Q10.1 (B), R37.1
unnamed: D10.C, Q10.3 (C)
unnamed: D10.A, R36.1
unnamed: Q11.1 (B), R39.1
unnamed: D11.C, Q11.3 (C)
unnamed: D11.A, R38.1
unnamed: Q12.1 (B), R41.1
unnamed: D12.C, Q12.3 (C)
unnamed: D12.A, R40.1
unnamed: Q13.1 (B), R43.1
unnamed: D13.C, Q13.3 (C)
unnamed: D13.A, R42.1
unnamed: D14.AR (RED-A), R44.1
unnamed: D14.AB (BLU-A), R45.1
unnamed: D14.CR (RED-C), Q14.3 (C)
unnamed: D14.CB (BLU-C), Q15.3 (C)
unnamed: Q14.1 (B), R46.2
unnamed: Q15.1 (B), R47.2
VDD: R18.2, R20.2, R22.2, R24.2, R26.2, R28.2, R30.2, R32.2, R34.2, R36.2, R38.2, R40.2, R42.2, R44.2, R45.2; also elsewhere on the board
VSS: Q1.2 (E), Q2.2 (E), Q3.2 (E), Q4.2 (E), Q5.2 (E), Q6.2 (E), Q7.2 (E), Q8.2 (E), Q9.2 (E), Q10.2 (E), Q11.2 (E), Q12.2 (E), Q13.2 (E), Q14.2 (E), Q15.2 (E); also elsewhere on the board

Notes on the sheet:
BYPASS LED
TAP/HOLD LED
LED Array
(c) Tom Grubb 2018
SIEGER AUDIO

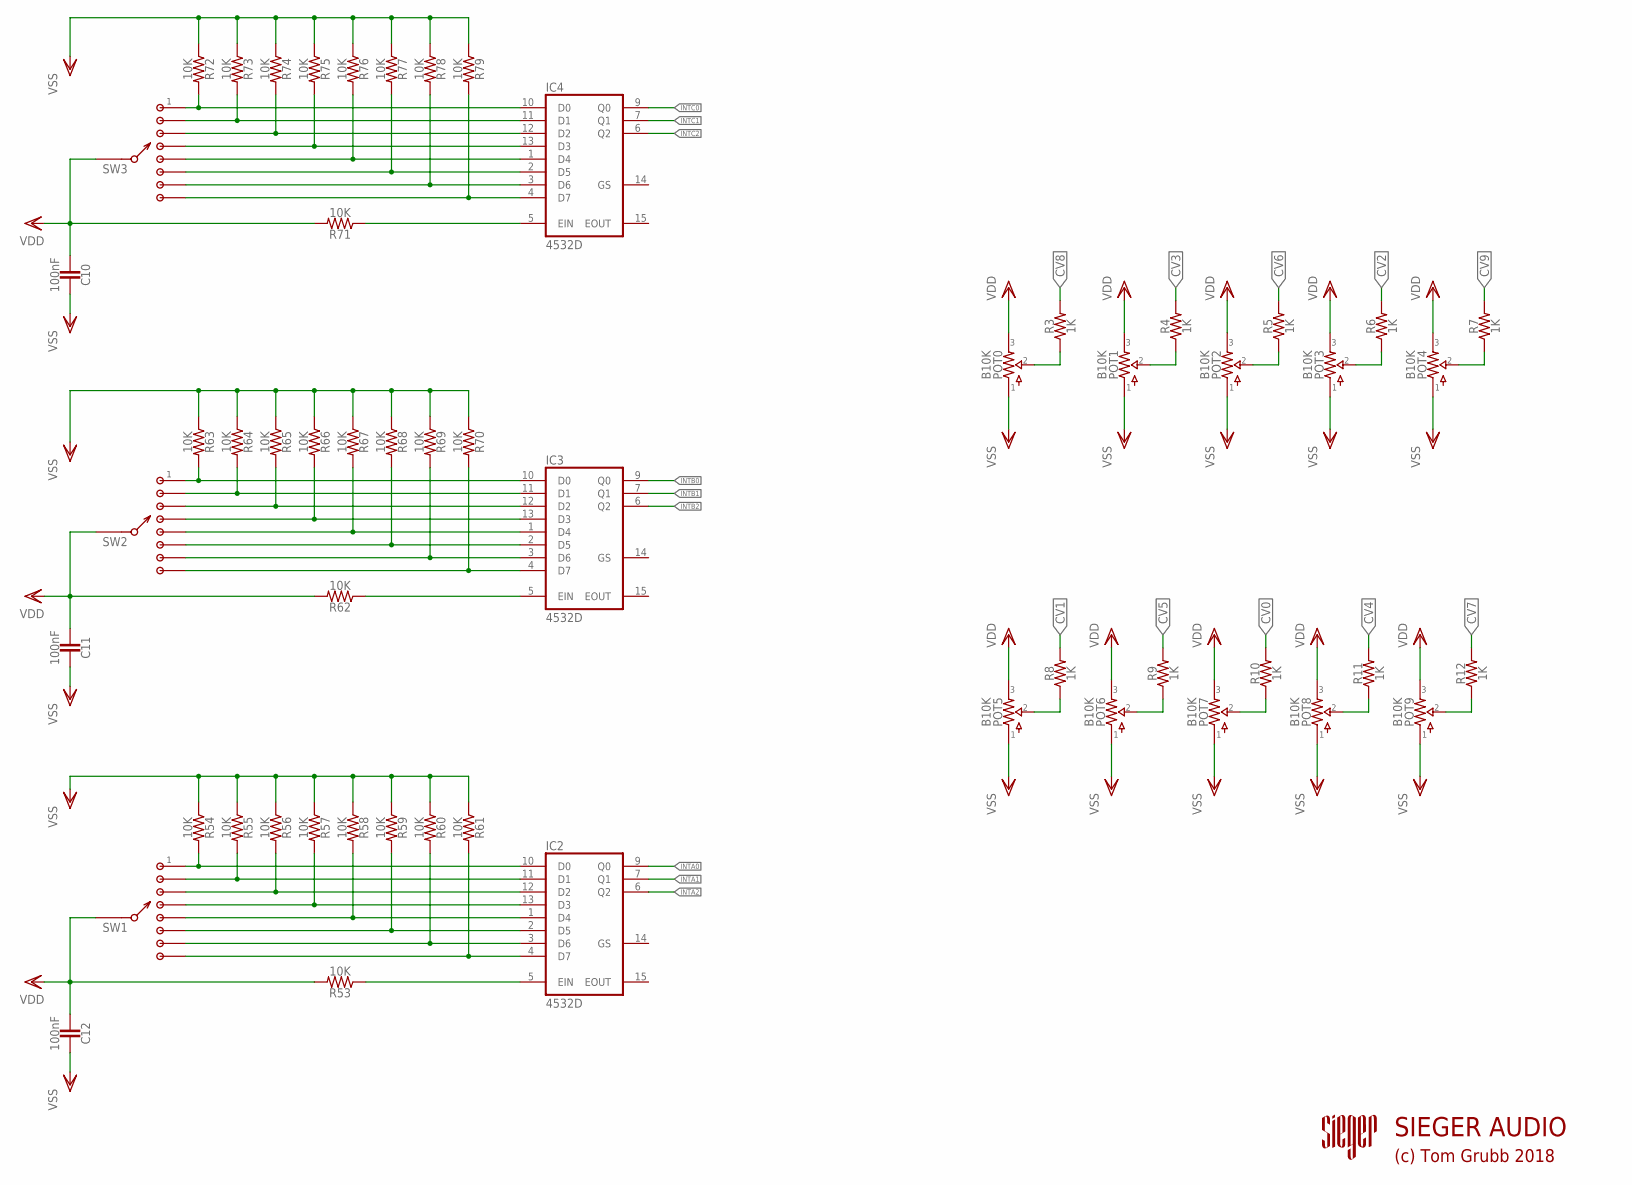
[picture p12: schematic PitchshiftDelay-Control-v1.2.sch, sheet 4]

Parts:
C10, C11, C12: 100nF; 050X030_025
IC2, IC3, IC4: 4532D; SO16
POT0, POT1, POT2, POT3, POT4, POT5, POT6, POT7, POT8, POT9: B10K; 9MM_W/MOUNTS-2MMHOLES
R3, R4, R5, R6, R7, R8, R9, R10, R11, R12: 1K; RESISTOR_C0805
R53, R54, R55, R56, R57, R58, R59, R60, R61, R62, R63, R64, R65, R66, R67, R68, R69, R70, R71, R72, R73, R74, R75, R76, R77, R78, R79: 10K; RESISTOR_C0805
SW1, SW2, SW3: 1P8T; SMALLROTARY

Connections:
CV0: R10.2; also elsewhere on the board
CV1: R8.2; also elsewhere on the board
CV2: R6.2; also elsewhere on the board
CV3: R4.2; also elsewhere on the board
CV4: R11.2; also elsewhere on the board
CV5: R9.2; also elsewhere on the board
CV6: R5.2; also elsewhere on the board
CV7: R12.2; also elsewhere on the board
CV8: R3.2; also elsewhere on the board
CV9: R7.2; also elsewhere on the board
INTA0: IC2.9 (Q0); also elsewhere on the board
INTA1: IC2.7 (Q1); also elsewhere on the board
INTA2: IC2.6 (Q2); also elsewhere on the board
INTB0: IC3.9 (Q0); also elsewhere on the board
INTB1: IC3.7 (Q1); also elsewhere on the board
INTB2: IC3.6 (Q2); also elsewhere on the board
INTC0: IC4.9 (Q0); also elsewhere on the board
INTC1: IC4.7 (Q1); also elsewhere on the board
INTC2: IC4.6 (Q2); also elsewhere on the board
unnamed: POT0.P$2 (2), R3.1
unnamed: POT1.P$2 (2), R4.1
unnamed: POT2.P$2 (2), R5.1
unnamed: POT3.P$2 (2), R6.1
unnamed: POT4.P$2 (2), R7.1
unnamed: POT5.P$2 (2), R8.1
unnamed: POT6.P$2 (2), R9.1
unnamed: POT7.P$2 (2), R10.1
unnamed: POT8.P$2 (2), R11.1
unnamed: POT9.P$2 (2), R12.1
unnamed: IC2.5 (EIN), R53.1
unnamed: IC3.10 (D0), R63.2, SW2.1
unnamed: IC3.11 (D1), R64.2, SW2.2
unnamed: IC3.12 (D2), R65.2, SW2.3
unnamed: IC3.13 (D3), R66.2, SW2.4
unnamed: IC2.10 (D0), R54.2, SW1.1
unnamed: IC2.11 (D1), R55.2, SW1.2
unnamed: IC2.12 (D2), R56.2, SW1.3
unnamed: IC2.13 (D3), R57.2, SW1.4
unnamed: IC2.1 (D4), R58.2, SW1.5
unnamed: IC2.2 (D5), R59.2, SW1.6
unnamed: IC2.3 (D6), R60.2, SW1.7
unnamed: IC2.4 (D7), R61.2, SW1.8
unnamed: IC3.1 (D4), R67.2, SW2.5
unnamed: IC3.2 (D5), R68.2, SW2.6
unnamed: IC3.3 (D6), R69.2, SW2.7
unnamed: IC3.4 (D7), R70.2, SW2.8
unnamed: IC3.5 (EIN), R62.1
unnamed: IC4.10 (D0), R72.2, SW3.1
unnamed: IC4.11 (D1), R73.2, SW3.2
unnamed: IC4.12 (D2), R74.2, SW3.3
unnamed: IC4.13 (D3), R75.2, SW3.4
unnamed: IC4.1 (D4), R76.2, SW3.5
unnamed: IC4.2 (D5), R77.2, SW3.6
unnamed: IC4.3 (D6), R78.2, SW3.7
unnamed: IC4.4 (D7), R79.2, SW3.8
unnamed: IC4.5 (EIN), R71.1
VDD: C10.2, C11.2, C12.2, IC2.16 (VDD), IC3.16 (VDD), IC4.16 (VDD), POT0.P$3 (3), POT1.P$3 (3), POT2.P$3 (3), POT3.P$3 (3), POT4.P$3 (3), POT5.P$3 (3), POT6.P$3 (3), POT7.P$3 (3), POT8.P$3 (3), POT9.P$3 (3), R53.2, R62.2, R71.2, SW1.C (A), SW2.C (A), SW3.C (A); also elsewhere on the board
VSS: C10.1, C11.1, C12.1, IC2.8 (VSS), IC3.8 (VSS), IC4.8 (VSS), POT0.P$1 (1), POT1.P$1 (1), POT2.P$1 (1), POT3.P$1 (1), POT4.P$1 (1), POT5.P$1 (1), POT6.P$1 (1), POT7.P$1 (1), POT8.P$1 (1), POT9.P$1 (1), R54.1, R55.1, R56.1, R57.1, R58.1, R59.1, R60.1, R61.1, R63.1, R64.1, R65.1, R66.1, R67.1, R68.1, R69.1, R70.1, R72.1, R73.1, R74.1, R75.1, R76.1, R77.1, R78.1, R79.1; also elsewhere on the board

Notes on the sheet:
(c) Tom Grubb 2018
SIEGER AUDIO

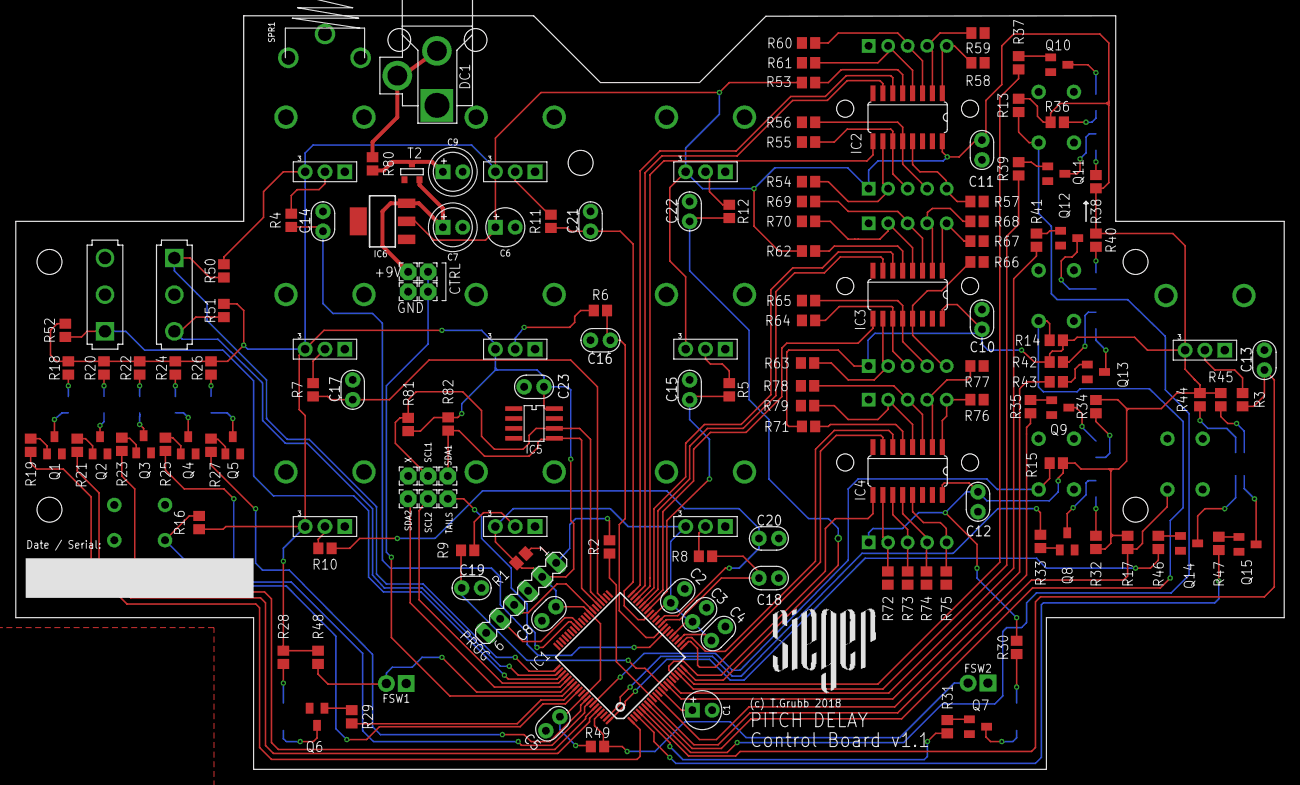
[picture p13: board PitchshiftDelay-Control-v1.2.brd from above]

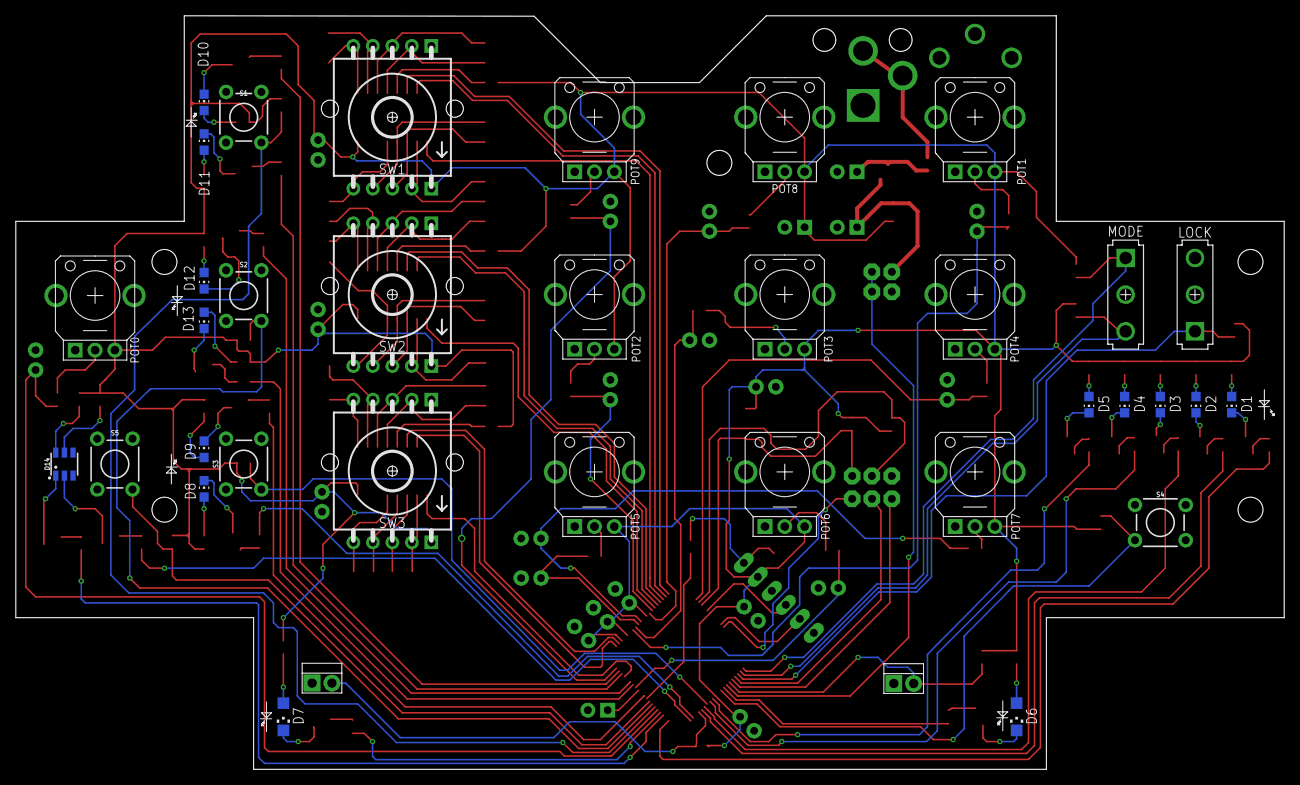
[picture p14: board PitchshiftDelay-Control-v1.2.brd from below]

Board: 2 copper layers, 162.6 x 96.6 mm, 177 parts (21 on the bottom side), 142 nets.

Other parts of the board:
U$1: LARGE
